meerstern/e-Paper_I2C_Module/README.md

# e-Paper I2C モジュール
The e-Paper I2C Module of Kicad Files for 1.54inch E-Ink raw display panel. 

e-Paper I2Cモジュールは[WAVESHARE製200x200, 1.54inch E-Inkディスプレイ][0]を搭載したモジュールです。<br>
[WAVESHARE製200x200, 1.54inch E-Inkディスプレイ][0]はSPI接続ですが、
配線の容易性を実現するために[SPI I2CプロトコルブリッジIC SC18IS602B][1]を搭載してI2C化しています。<br>
I2C接続のため、SPI接続に比べて描画速度が遅くなりますが、I2C接続で電源線と信号線2本で簡単に接続が可能です。<br>
また、I2CはGroveコネクタを搭載することでラピッドプロトタイピングに対応しています。<br><br>

サンプルプログラムはArduinoとSTM32(SW4STM32)のコードがあります。<br>
[メーカ提供のデモプログラム][2]をSPI I2CプロトコルブリッジICを介して動作するように書き換えています。<br><br>

※注意※<br>
 基板裏面に[V2]マークがある場合は[V2版1.54inch E-Inkディスプレイ][2]のため、V2が付いたサンプルプログラムを使用してください。
V1とV2はハードウェア上の互換性がありますが、プログラム/ファームウェアの互換性はありません。2020年4月以降はV2版が出荷されます。<br>

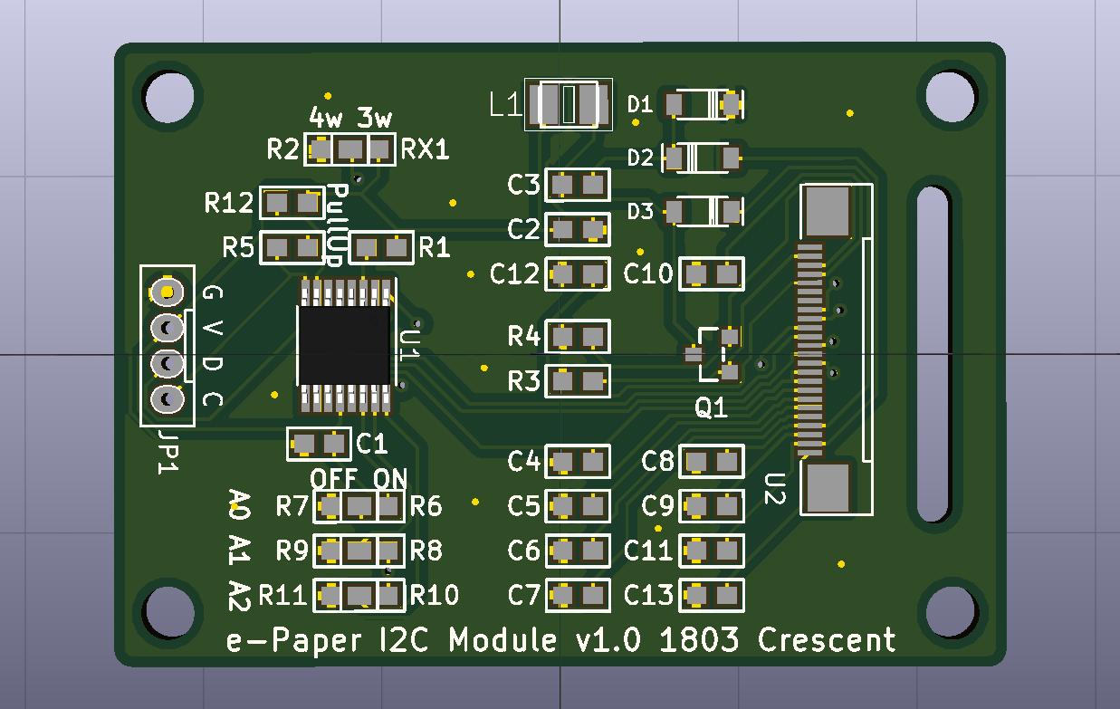
[picture p1: e-paper1.jpg]


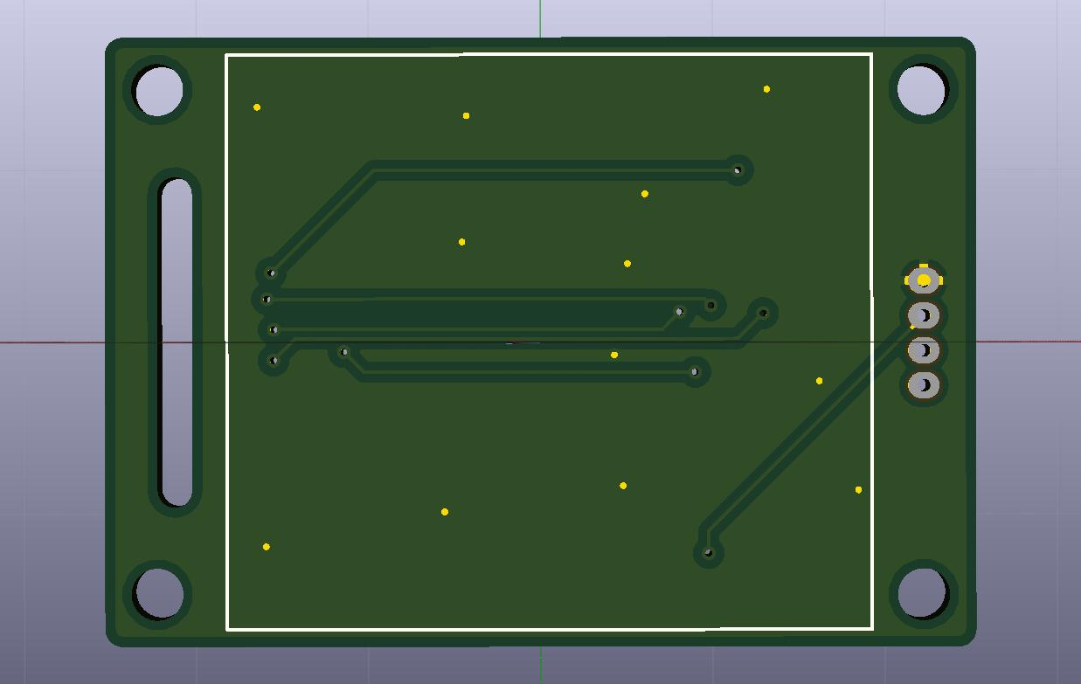
[picture p2: e-paper2.jpg]


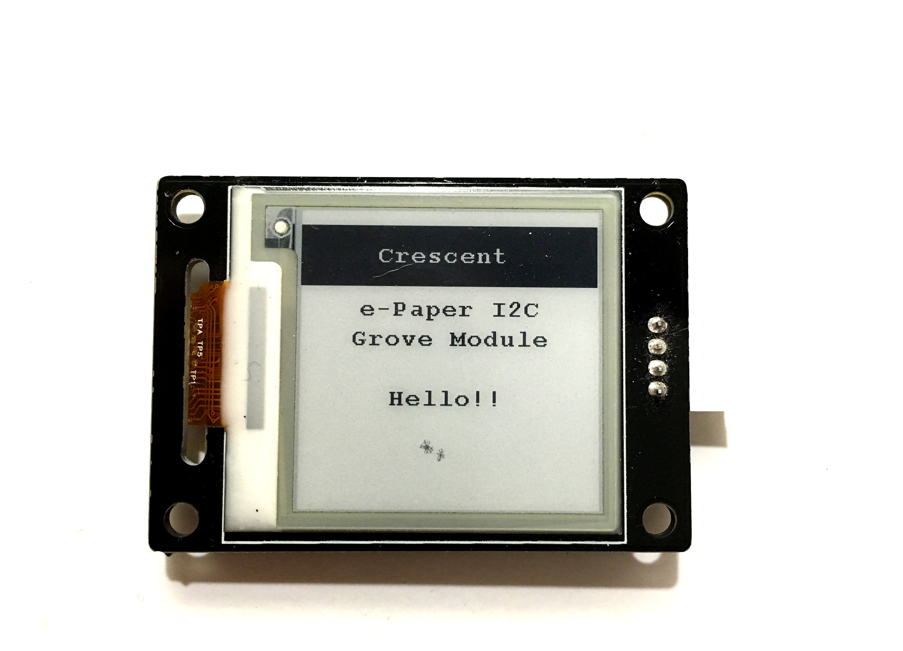
[picture p3: e-paper3.JPG]


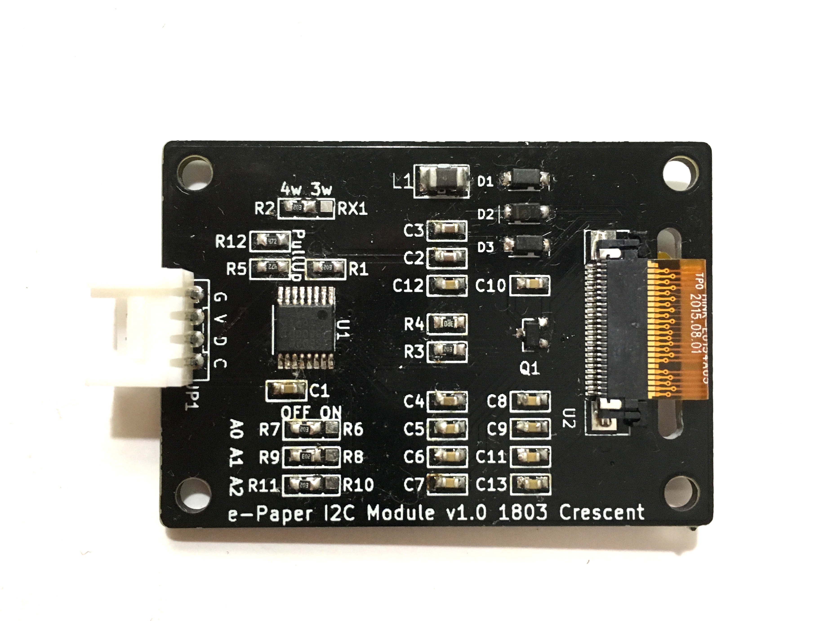
[picture p4: e-paper4.JPG]


## e-Paper I2Cモジュール仕様
  * WAVESHARE製200x200, 1.54inch E-Inkディスプレイ搭載
  * 電源3.3V、I2C接続(Groveコネクタ)
  * E-Inkディスプレイの制御ピンはSPI I2CプロトコルブリッジICのGPIOピンに接続されています<br>
  　GPIO0:CS、GPIO1:Busy、GPIO2:DC、GPIO3:Reset
  * 取付穴M3、穴ピッチ44mm x29mm
  
## 販売サイト
  * [スイッチサイエンス][3]

## 告知
  * SC18IS602の後継ICのSC18IS606PWJはGPIOピンが3つに減ったため、本モジュールの代替ICとして使用できないことが分かりました  
  * よって、SC18IS602の生産完了に伴い、本モジュールについてもIC在庫がなくなり次第、販売を終了する予定です  

[0]: https://www.waveshare.com/product/1.54inch-e-paper.htm "*0"
[1]: https://www.nxp.com/products/analog/signal-chain/bridges/ic-bus-to-spi-bridge:SC18IS602B "*1"
[2]: https://www.waveshare.com/wiki/1.54inch_e-Paper_Module "*2"
[3]: https://www.switch-science.com/products/3887
