meerstern/e-Paper_I2C_Module/SampleCode/SW4STM32/STM32F303_Grove-ePaper_v2/STM32F303_Grove-ePaper.pdf

## STM32F303_Grove-ePaper Project Configuration Report

# 1. Description

## 1.1. Project

Project Name | STM32F303_Grove-ePaper
Board Name | NUCLEO-F303K8
Generated with: | STM32CubeMX 4.25.0
Date | 04/09/2018

## 1.2. MCU

MCU Series | STM32F3
MCU Line | STM32F303
MCU name | STM32F303K8Tx
MCU Package | LQFP32
MCU Pin number | 32

# 2. Pinout Configuration

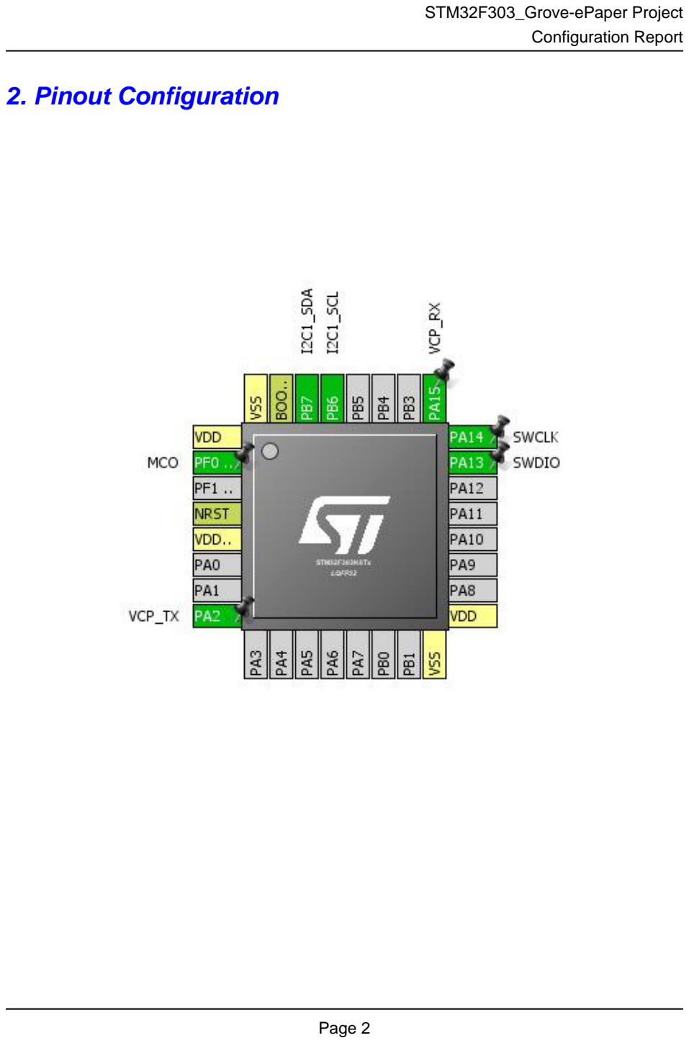
[picture p5: page 2]

# 3. Pins Configuration

Pin Number LQFP32 | Pin Name (function after reset) | Pin Type | Alternate Function(s) | Label
1 | VDD | Power
2 | PF0 / OSC_IN | I/O | RCC_OSC_IN | MCO
4 | NRST | Reset
5 | VDDA/VREF+ | Power
8 | PA2 | I/O | USART2_TX | VCP_TX
16 | VSS | Power
17 | VDD | Power
23 | PA13 | I/O | SYS_JTMS-SWDIO | SWDIO
24 | PA14 | I/O | SYS_JTCK-SWCLK | SWCLK
25 | PA15 | I/O | USART2_RX | VCP_RX
29 | PB6 | I/O | I2C1_SCL
30 | PB7 | I/O | I2C1_SDA
31 | BOOT0 | Boot
32 | VSS | Power

# 4. Clock Tree Configuration

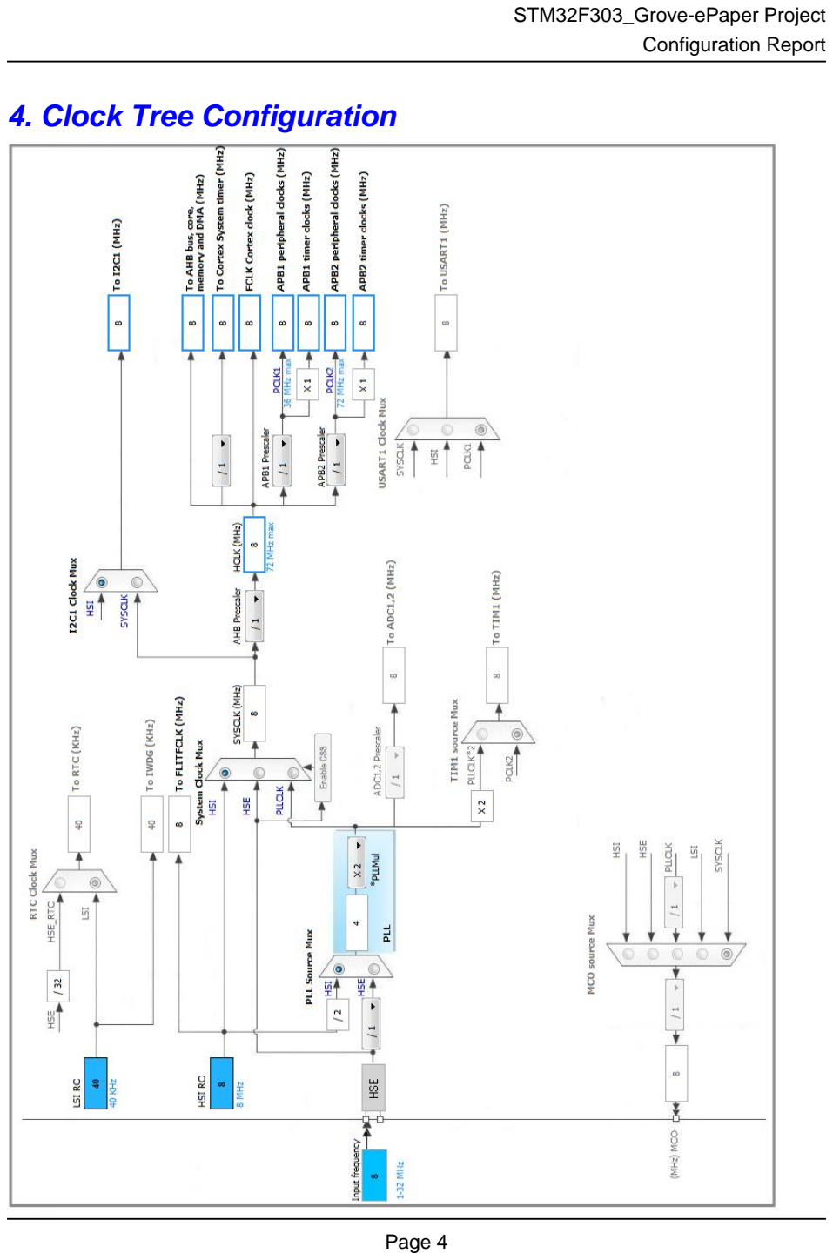
[picture p6: page 4]

# 5. IPs and Middleware Configuration

# 5.1. I2C1

## I2C: I2C

## 5.1.1. Parameter Settings:

### Timing configuration:

I2C Speed Mode | Standard Mode
I2C Speed Frequency (KHz) | 100
Rise Time (ns) | 0
Fall Time (ns) | 0
Coefficient of Digital Filter | 0
Analog Filter | Enabled
Timing | 0x2000090E

### Slave Features:

Clock No Stretch Mode | Disabled
General Call Address Detection | Disabled
Primary Address Length selection | 7-bit
Dual Address Acknowledged | Disabled
Primary slave address | 0

# 5.2. RCC

## High Speed Clock (HSE): BYPASS Clock Source

## 5.2.1. Parameter Settings:

### System Parameters:

VDD voltage (V) | 3.3
Prefetch Buffer | Enabled
Flash Latency(WS) | 0 WS (1 CPU cycle)

### RCC Parameters:

HSI Calibration Value | 16
HSE Startup Timout Value (ms) | 100
LSE Startup Timout Value (ms) | 5000

# 5.3. SYS

## Debug: Serial Wire Timebase Source: SysTick

# 5.4. USART2

## Mode: Asynchronous

## 5.4.1. Parameter Settings:

### Basic Parameters:

Baud Rate | 9600 *
Word Length | 8 Bits (including Parity) *
Parity | None
Stop Bits | 1

### Advanced Parameters:

Data Direction | Receive and Transmit
Over Sampling | 16 Samples
Single Sample | Disable

### Advanced Features:

TX Pin Active Level Inversion | Disable
RX Pin Active Level Inversion | Disable
Data Inversion | Disable
TX and RX Pins Swapping | Disable
Overrun | Enable
DMA on RX Error | Enable
MSB First | Disable

### * User modified value

# 6. System Configuration

# 6.1. GPIO configuration

IP | Pin | Signal | GPIO mode | GPIO pull/up pull down | Max Speed | User Label
I2C1 | PB6 | I2C1_SCL | Alternate Function Open Drain | Pull up | High *
| PB7 | I2C1_SDA | Alternate Function Open Drain | Pull up | High *
RCC | PF0 / OSC_IN | RCC_OSC_IN | n/a | n/a | n/a | MCO
SYS | PA13 | SYS_JTMS-SWDIO | n/a | n/a | n/a | SWDIO
| PA14 | SYS_JTCK-SWCLK | n/a | n/a | n/a | SWCLK
USART2 | PA2 | USART2_TX | Alternate Function Push Pull | No pull up pull down | High * | VCP_TX
| PA15 | USART2_RX | Alternate Function Push Pull | No pull up pull down | High * | VCP_RX

# 6.2. DMA configuration

## nothing configured in DMA service

# 6.3. NVIC configuration

Interrupt Table | Enable | Preenmption Priority | SubPriority
Non maskable interrupt | true | 0 | 0
Hard fault interrupt | true | 0 | 0
Memory management fault | true | 0 | 0
Pre-fetch fault, memory access fault | true | 0 | 0
Undefined instruction or illegal state | true | 0 | 0
System service call via SWI instruction | true | 0 | 0
Debug monitor | true | 0 | 0
Pendable request for system service | true | 0 | 0
System tick timer | true | 0 | 0
PVD interrupt through EXTI line 16 | unused
Flash global interrupt | unused
RCC global interrupt | unused
I2C1 event global interrupt / I2C1 wake-up interrupt through EXT line 23 | unused
I2C1 error interrupt | unused
USART2 global interrupt / USART2 wake-up interrupt through EXT line 26 | unused
Floating point unit interrupt | unused

### * User modified value

# 7. Power Consumption Calculator report

### 7.1. Microcontroller Selection

Series | STM32F3
Line | STM32F303
MCU | STM32F303K8Tx
Datasheet | 025083_Rev5

### 7.2. Parameter Selection

Temperature | 25
Vdd | 3.6

# 8. Software Project

## 8.1. Project Settings

Name | Value
Project Name | STM32F303_Grove-ePaper
Project Folder | C:\Users\stern\workspace\STM32F303_Grove-ePaper
Toolchain / IDE | SW4STM32
Firmware Package Name and Version | STM32Cube FW_F3 V1.9.0

## 8.2. Code Generation Settings

Name | Value
STM32Cube Firmware Library Package | Copy only the necessary library files
Generate peripheral initialization as a pair of '.c/.h' files | Yes
Backup previously generated files when re-generating | Yes
Delete previously generated files when not re-generated | Yes
Set all free pins as analog (to optimize the power consumption) | No

# 9. Software Pack Report
