meerstern/e-Paper_I2C_Module/(list of files, drawings)

Other design files:
epaper.dsn
