meerstern/e-Paper_I2C_Module/epaper.kicad_pcb

## KiCad design epaper.kicad_pcb (2018-05-19)

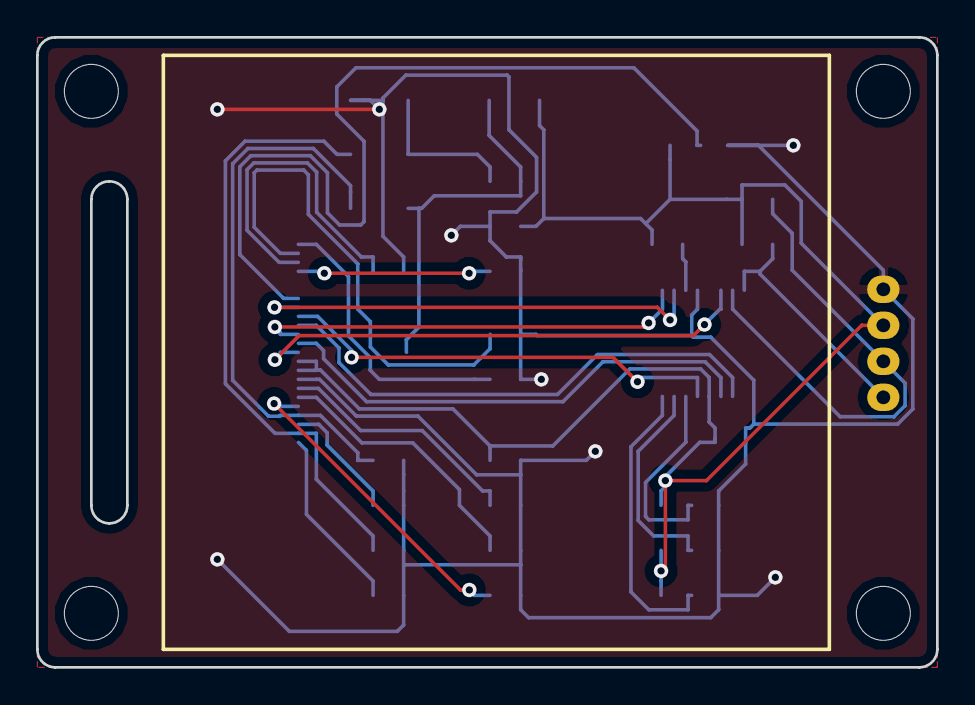
[picture p7: board epaper.kicad_pcb from above]

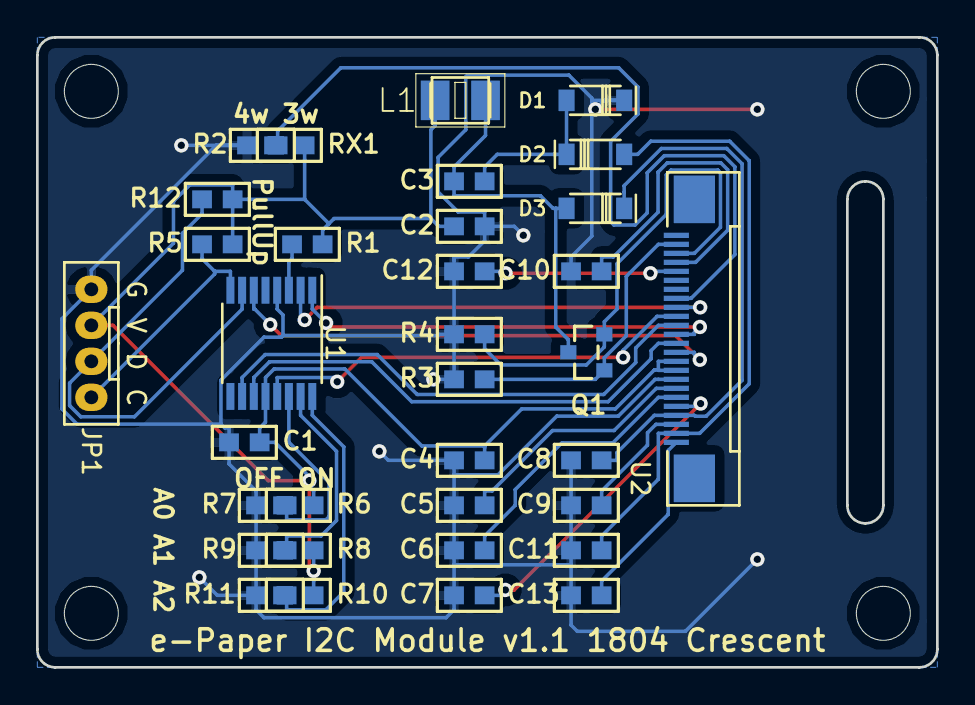
[picture p8: board epaper.kicad_pcb from below]

Board: 2 copper layers, 50.0 x 35.0 mm, 38 parts (34 on the bottom side), 28 nets.

Parts:
C1, C2, C3, C4, C5, C6, C7, C8, C9, C10, C11, C12, C13: C; C-0603
D1, D2, D3: D; SOD-123
JP1: GROVE
L1: L_Small; rcl-L3230M
Q1: Q_NMOS_GSD; SOT23
R1, R2, R3, R4, R5, R6, R7, R8, R9, R10, R11, R12: R; R-0603
REF1, REF2, REF3, REF4: MountingHole_3mm
RX1: R; R-0603
U1: SC18IS602B; TSSOP-16_4.4x5mm_Pitch0.65mm_without_pad
U2: e-paper; 24pin0.5mm

Connections:
/3.3V: C1.1, C2.1, C4.1, JP1.3, L1.2, R1.1, R5.1, R6.1, R8.1, R10.1, R12.1, RX1.1, U1.12, U2.9, U2.10
/GDR: Q1.1, R3.1, U2.23
/PREVGH: C8.1, D3.K, U2.4
/PREVGL: C11.1, D2.A, U2.2
/RESE: Q1.2, R4.1, U2.22
/SCL: JP1.1, R5.2, U1.8
/SDA: JP1.2, R12.2, U1.7
/cA0: R6.2, R7.1, U1.14
/cA1: R8.2, R9.1, U1.15
/cA2: R10.2, R11.1, U1.16
/eBS: R2.1, RX1.2, U2.17
/eBUSY: U1.2, U2.16
/eCLK: U1.11, U2.12
/eCS: U1.1, U2.13
/eDC: U1.10, U2.14
/eMOSI: U1.6, U2.11
/eRST: U1.13, U2.15
GND: C1.2, C2.2, C4.2, C5.2, C6.2, C7.2, C8.2, C9.2, C10.2, C11.2, C12.2, C13.2, D1.K, JP1.4, R2.2, R3.2, R4.2, R7.2, R9.2, R11.2, U1.4, U2.8
unnamed: C3.1, D1.A, D2.K
unnamed: C3.2, D3.A, L1.1, Q1.3
unnamed: C5.1, U2.7
unnamed: C6.1, U2.6
unnamed: C7.1, U2.5
unnamed: C9.1, U2.3
unnamed: C10.1, U2.21
unnamed: C12.1, U2.20
unnamed: C13.1, U2.1
unnamed: R1.2, U1.3
