meerstern/e-Paper_I2C_Module/SampleCode/SW4STM32/STM32F303_Grove-ePaper_v2/Src/main.c

/**
  ******************************************************************************
  * @file           : main.c
  * @brief          : Main program body
  ******************************************************************************
  ** This notice applies to any and all portions of this file
  * that are not between comment pairs USER CODE BEGIN and
  * USER CODE END. Other portions of this file, whether 
  * inserted by the user or by software development tools
  * are owned by their respective copyright owners.
  *
  * COPYRIGHT(c) 2018 STMicroelectronics
  *
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
  ******************************************************************************
  */
/* Includes ------------------------------------------------------------------*/
#include "main.h"
#include "stm32f3xx_hal.h"
#include "i2c.h"
#include "usart.h"
#include "gpio.h"

/* USER CODE BEGIN Includes */
#define USE_EPD1IN54_V2
//#define USE_EPD1IN54_V1
#ifdef USE_EPD1IN54_V1
	#include "epd1in54.h"
#endif
#ifdef USE_EPD1IN54_V2
	#include "epd1in54_v2.h"
#endif

#include "epdif.h"
#include "epdpaint.h"
#include "imagedata.h"
#include <stdlib.h>
#include "i2c-spi_bridge.h"
/* USER CODE END Includes */


/* USER CODE BEGIN PV */

/* USER CODE END PV */

void SystemClock_Config(void);

/* USER CODE BEGIN PFP */
int _write (int fd, char *ptr, int len)
{
  HAL_UART_Transmit(&huart2, (uint8_t*)ptr, len, 1000);
  return len;
}
/* USER CODE END PFP */

/* USER CODE BEGIN 0 */
#define COLORED      0
#define UNCOLORED    1
/* USER CODE END 0 */

/**
  * @brief  The application entry point.
  *
  * @retval None
  */
int main(void)
{
  /* MCU Configuration----------------------------------------------------------*/

  /* Reset of all peripherals, Initializes the Flash interface and the Systick. */
  HAL_Init();

  /* USER CODE BEGIN Init */
  unsigned char* frame_buffer = (unsigned char*)malloc(EPD_WIDTH * EPD_HEIGHT / 8);
  char time_string[] = {'0', '0', ':', '0', '0', '\0'};
  unsigned long time_start_ms;
  unsigned long time_now_s;

  /* USER CODE END Init */

  /* Configure the system clock */
  SystemClock_Config();

  /* Initialize all configured peripherals */
  MX_GPIO_Init();
  MX_USART2_UART_Init();
  MX_I2C1_Init();
  /* USER CODE BEGIN 2 */
  printf("Init OK! \n");

  if(HAL_I2C_Master_Transmit(&hi2c1,SC18IS602_ADDRESS,(uint8_t*)0x00,0,50)!=HAL_OK){
	  printf("DEV NOT FOUND!\n");
  }

  SC18IS602_InitDevice();


#ifdef USE_EPD1IN54_V1
  EPD epd;
  if (EPD_Init(&epd, lut_full_update) != 0) {
    printf("e-Paper init failed\n");
    return -1;
  }
#endif
#ifdef USE_EPD1IN54_V2
  EPD_1IN54_V2_Init();

#endif

  Paint paint;
  //printf("W:%d, H:%d \n",epd.width,epd.height);
  Paint_Init(&paint, frame_buffer, EPD_WIDTH, EPD_HEIGHT);
  Paint_Clear(&paint, UNCOLORED);
  Paint_SetRotate(&paint, ROTATE_270);


  /* For simplicity, the arguments are explicit numerical coordinates */
  /* Write strings to the buffer */
  Paint_DrawFilledRectangle(&paint, 0, 10, 200, 50, COLORED);

  Paint_DrawStringAt(&paint, 52, 24, "Crescent ", &Font16, UNCOLORED);
  Paint_DrawStringAt(&paint, 40, 60, "e-Paper I2C ", &Font16, COLORED);
  Paint_DrawStringAt(&paint, 35, 80, "Grove Module", &Font16, COLORED);

  Paint_DrawStringAt(&paint, 60, 120, "Hello!!", &Font16, COLORED);

  /* Display the frame_buffer */
#ifdef USE_EPD1IN54_V1
  EPD_SetFrameMemory(&epd, frame_buffer, 0, 0, Paint_GetWidth(&paint), Paint_GetHeight(&paint));
  EPD_DisplayFrame(&epd);
  EPD_SetFrameMemory(&epd, frame_buffer, 0, 0, Paint_GetWidth(&paint), Paint_GetHeight(&paint));
  EPD_DisplayFrame(&epd);
  EPD_DelayMs(&epd, 2000);
#endif

#ifdef USE_EPD1IN54_V2
  EPD_1IN54_V2_Display(frame_buffer);
  HAL_Delay(1000);
  EPD_1IN54_V2_Init();
  EPD_1IN54_V2_DisplayPartBaseImage(frame_buffer);
#endif

  while(1);



  /* EPD_or partial update */
#ifdef USE_EPD1IN54_V1
  if (EPD_Init(&epd, lut_partial_update) != 0) {
    printf("e-Paper init failed\n");
    return -1;
  }
#endif

  time_start_ms = HAL_GetTick();
  /* USER CODE END 2 */

  /* Infinite loop */
  /* USER CODE BEGIN WHILE */
  while (1)
  {

  /* USER CODE END WHILE */

  /* USER CODE BEGIN 3 */
	    time_now_s = (HAL_GetTick() - time_start_ms) / 1000;
	    time_string[0] = time_now_s / 60 / 10 + '0';
	    time_string[1] = time_now_s / 60 % 10 + '0';
	    time_string[3] = time_now_s % 60 / 10 + '0';
	    time_string[4] = time_now_s % 60 % 10 + '0';


#ifdef USE_EPD1IN54_V1
	    Paint_SetWidth(&paint, 32);
	    Paint_SetHeight(&paint, 96);
	    Paint_SetRotate(&paint, ROTATE_270);

	    Paint_Clear(&paint, UNCOLORED);
	    Paint_DrawStringAt(&paint, 10, 84, time_string, &Font24, COLORED);

	    EPD_SetFrameMemory(&epd, frame_buffer, 50, 100, Paint_GetWidth(&paint), Paint_GetHeight(&paint));
	    EPD_DisplayFrame(&epd);
#endif
#ifdef USE_EPD1IN54_V2

	    Paint_DrawFilledRectangle(&paint, 0, 140, 200, 180, UNCOLORED);
	    Paint_DrawStringAt(&paint, 50, 160, time_string, &Font24, COLORED);

	    EPD_1IN54_V2_DisplayPart(frame_buffer);

#endif

  }
  /* USER CODE END 3 */

}

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
