meerstern/e-Paper_I2C_Module/SampleCode/SW4STM32/STM32F303_Grove-ePaper_v2/STM32F303_Grove-ePaper.ioc

Mcu.UserName=STM32F303K8Tx
PA13.GPIO_Label=SWDIO
PA13.Signal=SYS_JTMS-SWDIO
PA14.GPIO_Label=SWCLK
PA14.Signal=SYS_JTCK-SWCLK
PA15.GPIO_Label=VCP_RX
PA15.Signal=USART2_RX
PA2.GPIO_Label=VCP_TX
PA2.Signal=USART2_TX
PB6.Signal=I2C1_SCL
PB7.Signal=I2C1_SDA
