meerstern/e-Paper_I2C_Module/(commit log)

2018-05-19 Fix the position of the HFL Connector
    [epaper-B.Cu.gbl, epaper-B.Mask.gbs, epaper-B.Paste.gbp, epaper-B.SilkS.gbo, epaper-Edge.Cuts.gm1, epaper-F.Cu.gtl, epaper-F.Mask.gts, epaper-F.Paste.gtp]
2018-05-19 Add sample code
2019-02-28 Update ino file for initizalition fail.
    Some MPU such as Arduino UNO cause initizalition fail.
    To avoid them, enable clear memory.
    [e-paper_I2C_Module.ino]
2019-11-16 Add sample code for V2
