meerstern/e-Paper_I2C_Module/(notices)

Notices in the files:
SampleCode/SW4STM32/STM32F303_Grove-ePaper_v2/Src/main.c:
(C) COPYRIGHT STMicroelectronics *****END OF FILE
